har-in-air/ESP8266_MPU9250_MS5611_VARIO/pics/vario_assembly_c.jpg

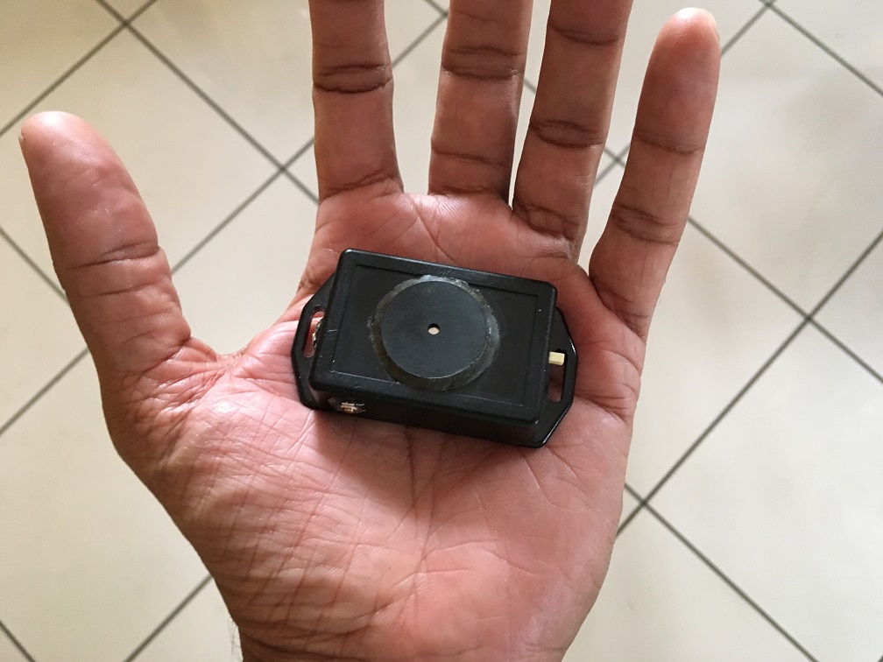
pics/vario_assembly_c.jpg
