har-in-air/ESP8266_MPU9250_MS5611_VARIO/pics/aliexpress_cp2102_usbuart.jpg

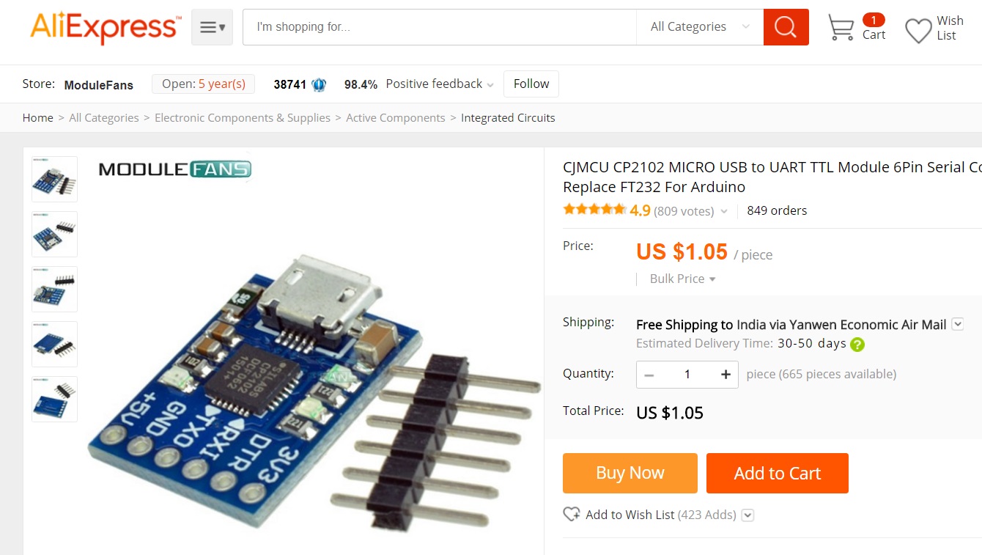
pics/aliexpress_cp2102_usbuart.jpg
