har-in-air/ESP8266_MPU9250_MS5611_VARIO/pics/aliexpress_esp8285_espm2.jpg

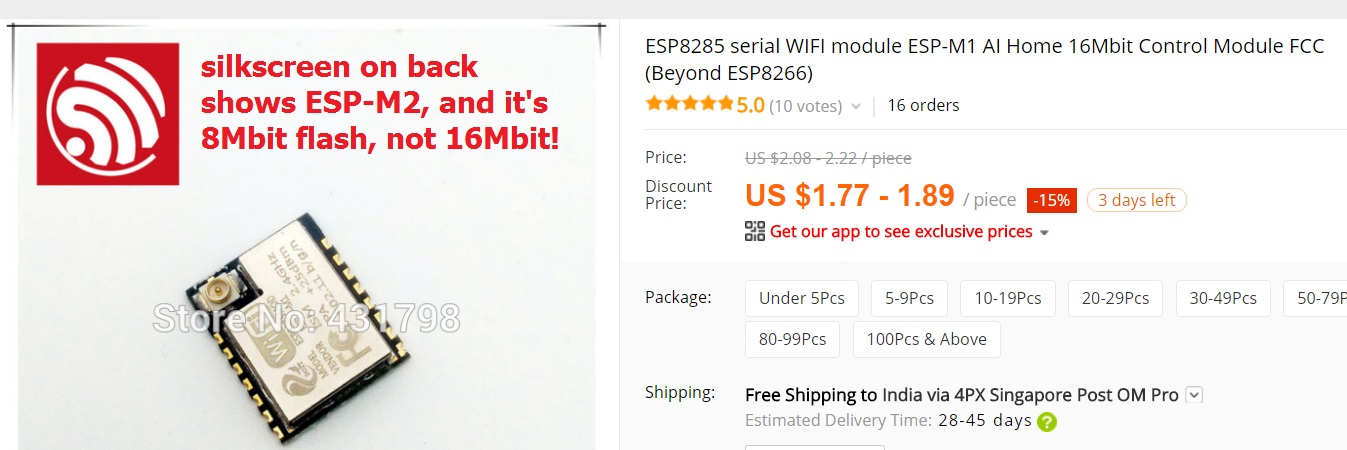
pics/aliexpress_esp8285_espm2.jpg
