har-in-air/ESP8266_MPU9250_MS5611_VARIO/pics/aliexpress_ht7333.jpg

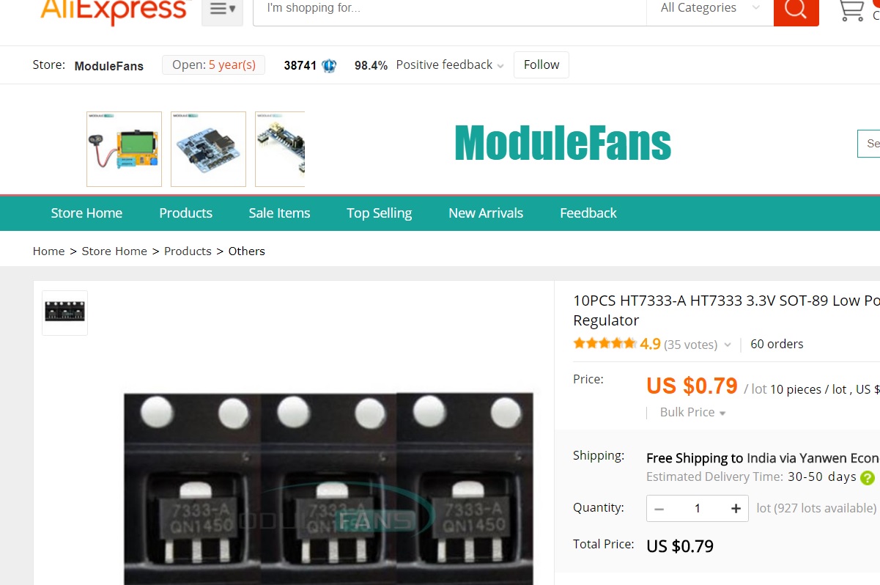
pics/aliexpress_ht7333.jpg
