har-in-air/ESP8266_MPU9250_MS5611_VARIO/pics/aliexpress_loud_piezo.png

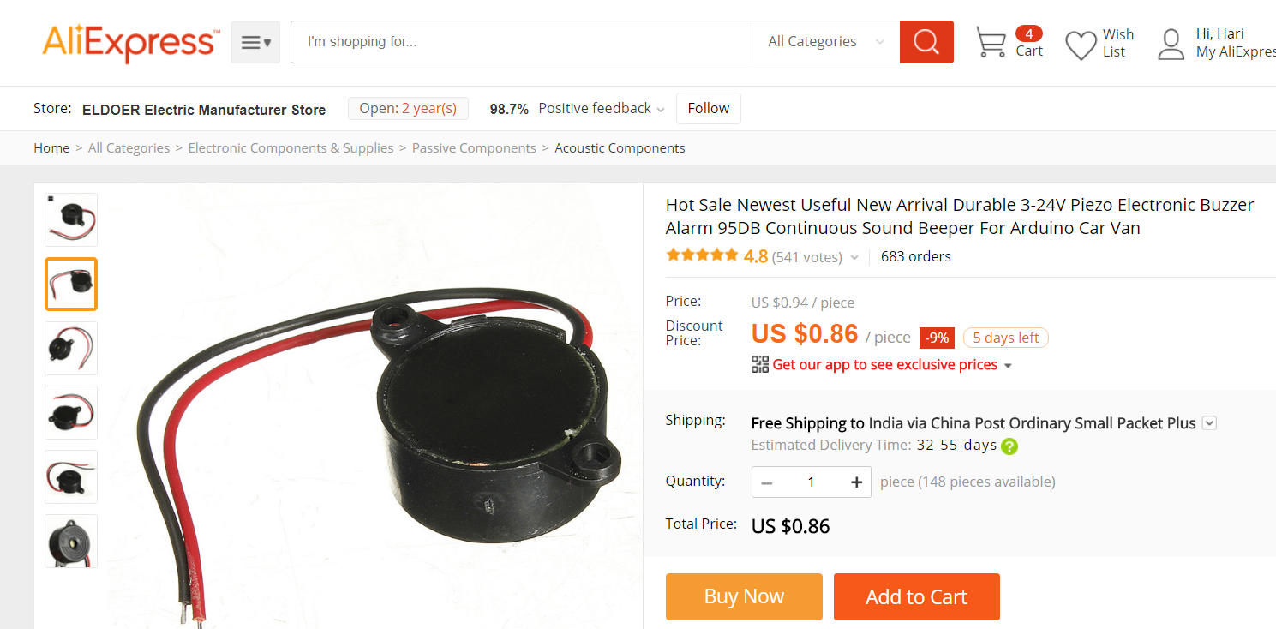
pics/aliexpress_loud_piezo.png
