har-in-air/ESP8266_MPU9250_MS5611_VARIO/pics/antoine_3dprinted_case.png

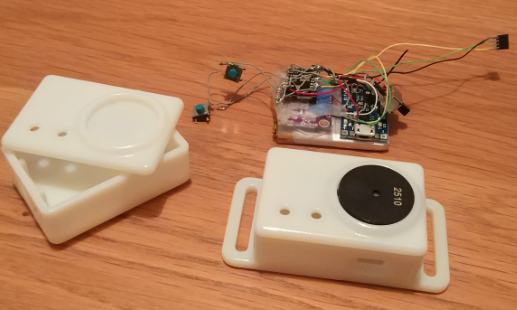
pics/antoine_3dprinted_case.png
