har-in-air/ESP8266_MPU9250_MS5611_VARIO/pics/arduino_board_select.png

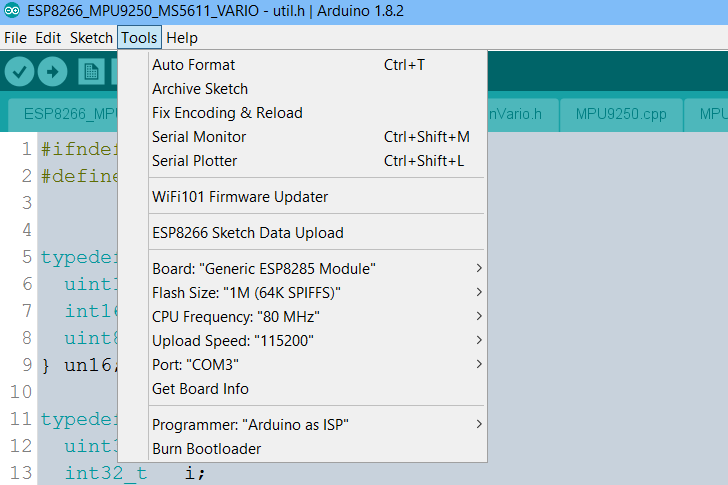
pics/arduino_board_select.png
