har-in-air/ESP8266_MPU9250_MS5611_VARIO/pics/Banggood LiPoly Battery 820mAh.png

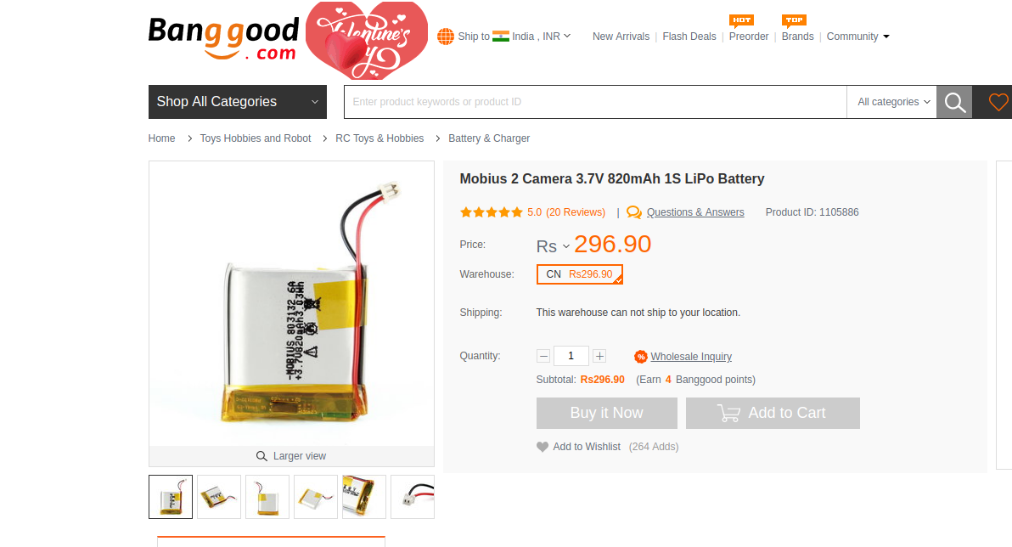
pics/Banggood LiPoly Battery 820mAh.png
