har-in-air/ESP8266_MPU9250_MS5611_VARIO/pics/cjmcu117.jpg

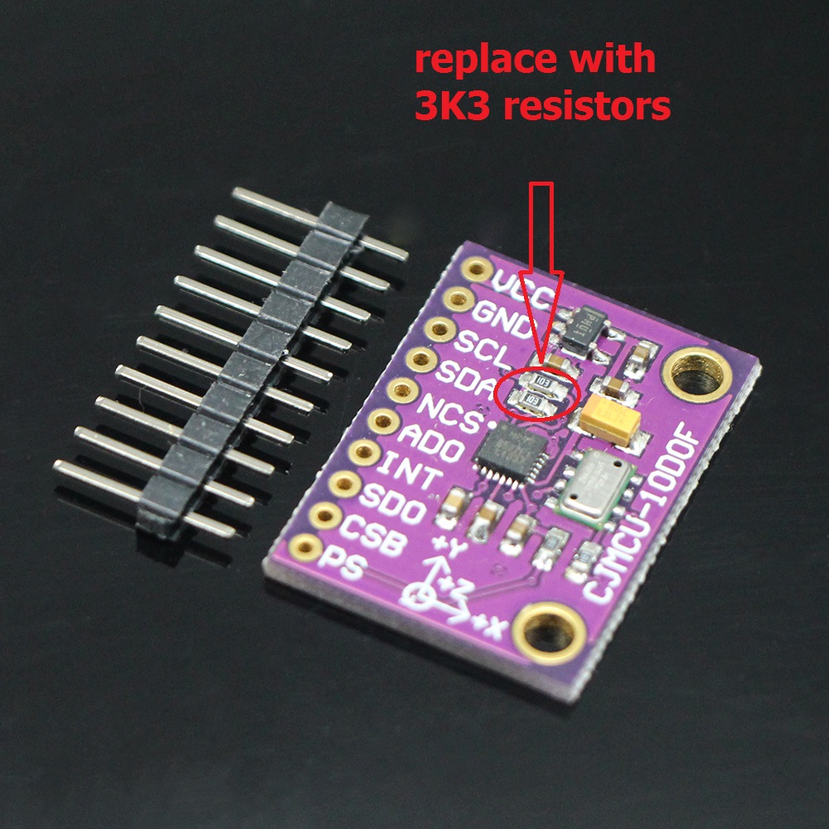
pics/cjmcu117.jpg
