har-in-air/ESP8266_MPU9250_MS5611_VARIO/pics/ebay_cjmcu117.png

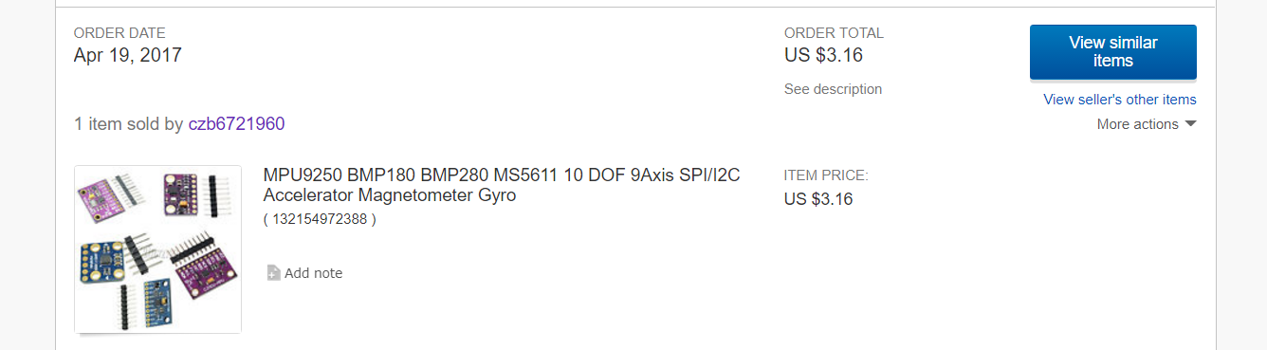
pics/ebay_cjmcu117.png
