har-in-air/ESP8266_MPU9250_MS5611_VARIO/pics/ebay_ht7333.png

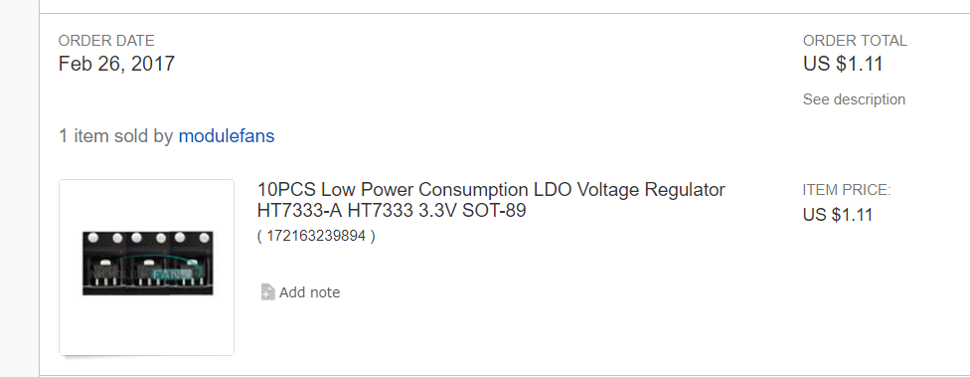
pics/ebay_ht7333.png
