har-in-air/ESP8266_MPU9250_MS5611_VARIO/pics/electrodragon_lipoly_charger.png

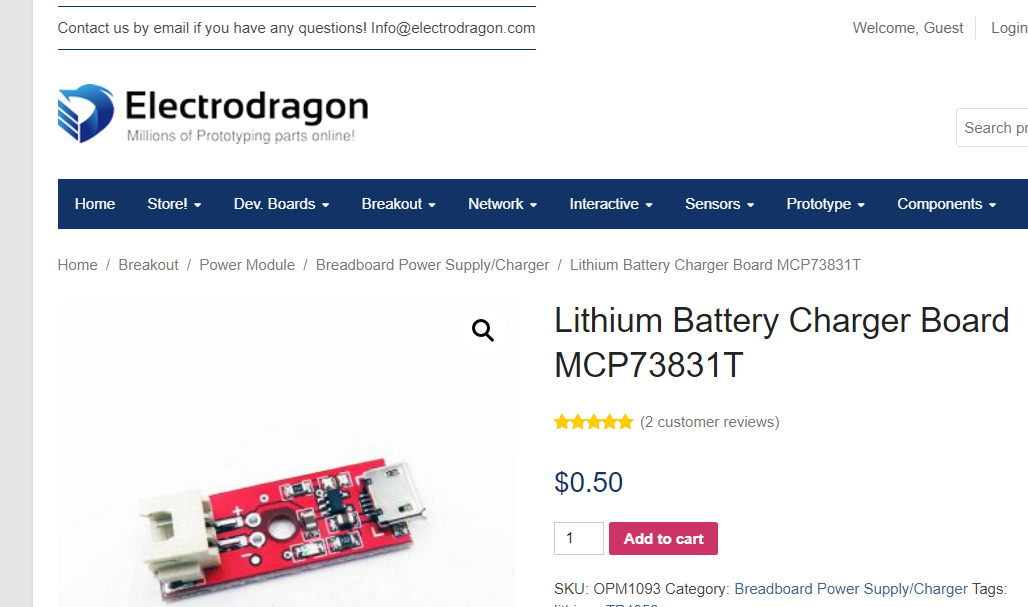
pics/electrodragon_lipoly_charger.png
