har-in-air/ESP8266_MPU9250_MS5611_VARIO/pics/esp8266_vario_memory_used.png

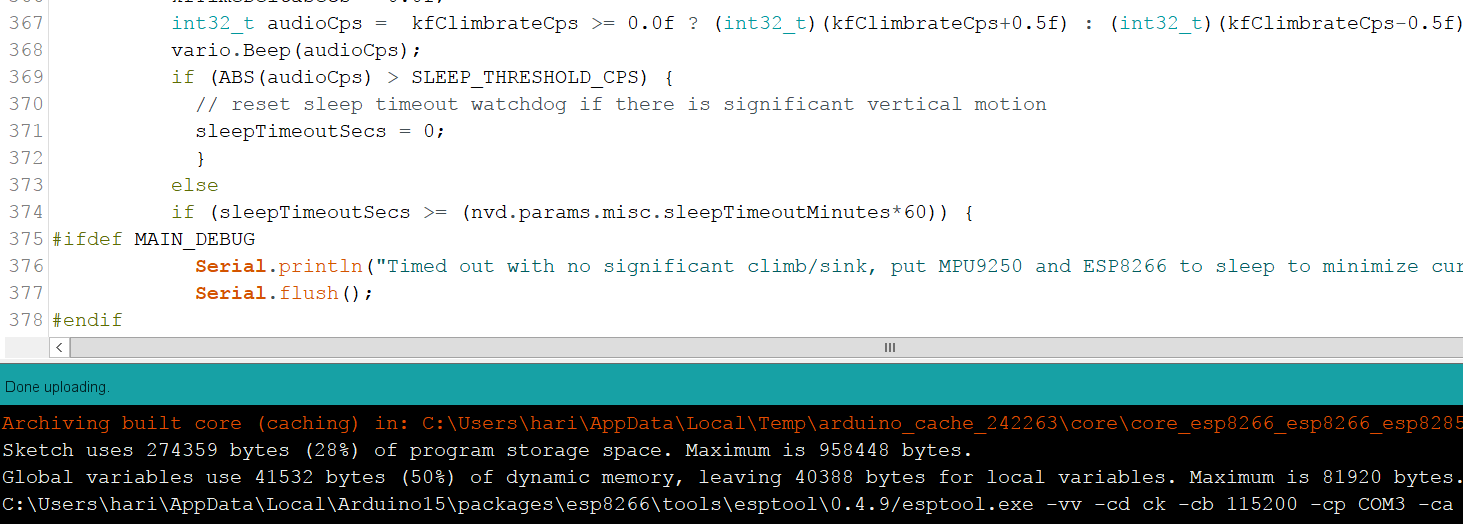
pics/esp8266_vario_memory_used.png
