har-in-air/ESP8266_MPU9250_MS5611_VARIO/pics/esp8285_m2_pinout.png

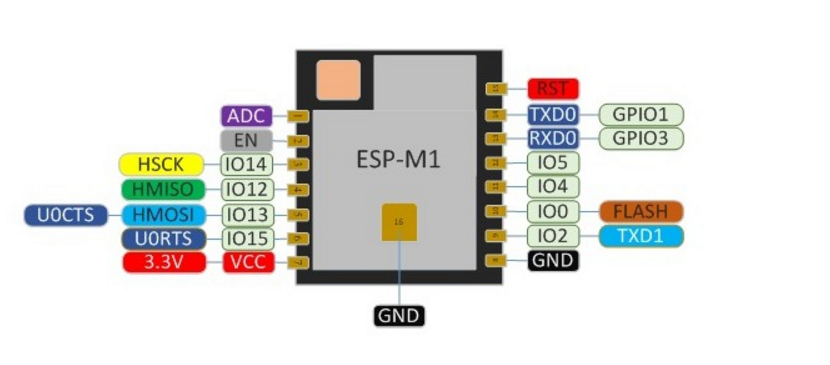
pics/esp8285_m2_pinout.png
