har-in-air/ESP8266_MPU9250_MS5611_VARIO/pics/monitor_normal_flow.png

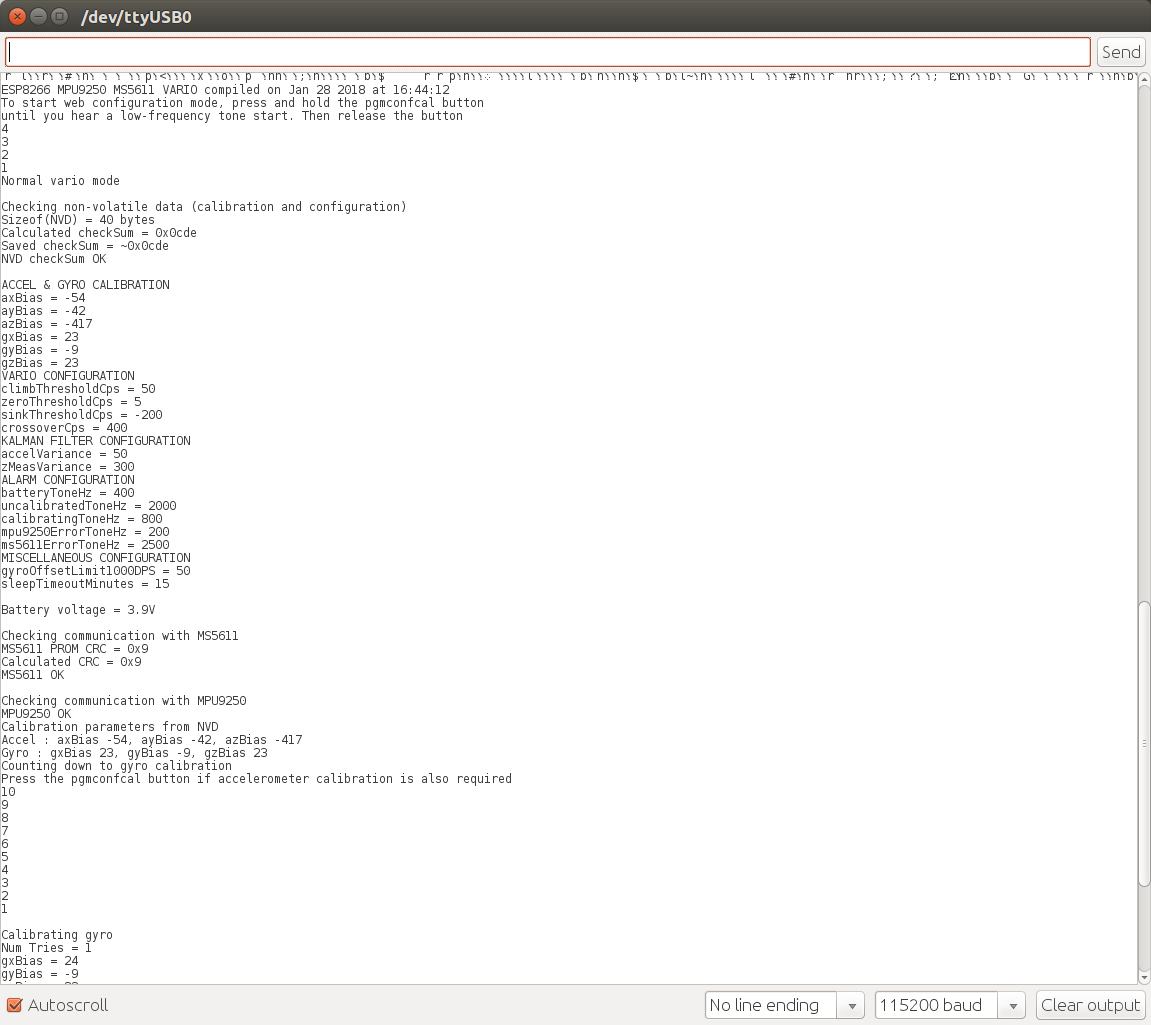
pics/monitor_normal_flow.png
