har-in-air/ESP8266_MPU9250_MS5611_VARIO/pics/vario_schematic.png

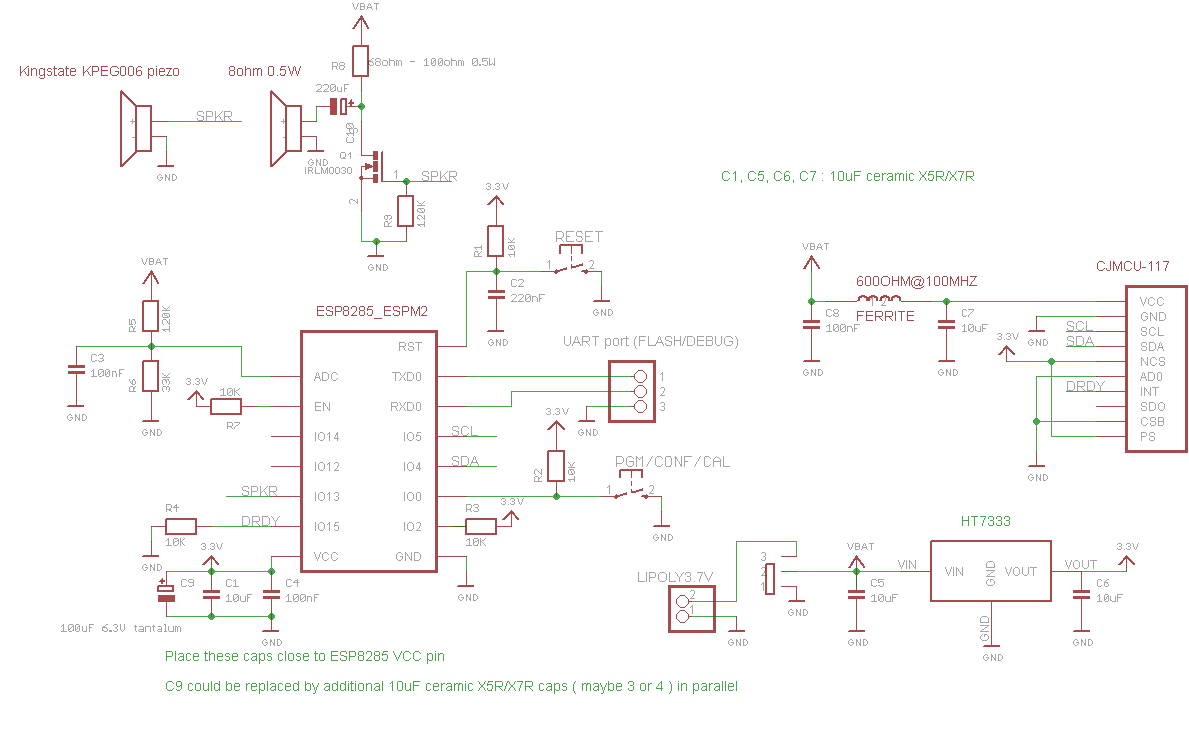
pics/vario_schematic.png
