har-in-air/ESP8266_MPU9250_MS5611_VARIO/pics/vario_assembly_d.jpg

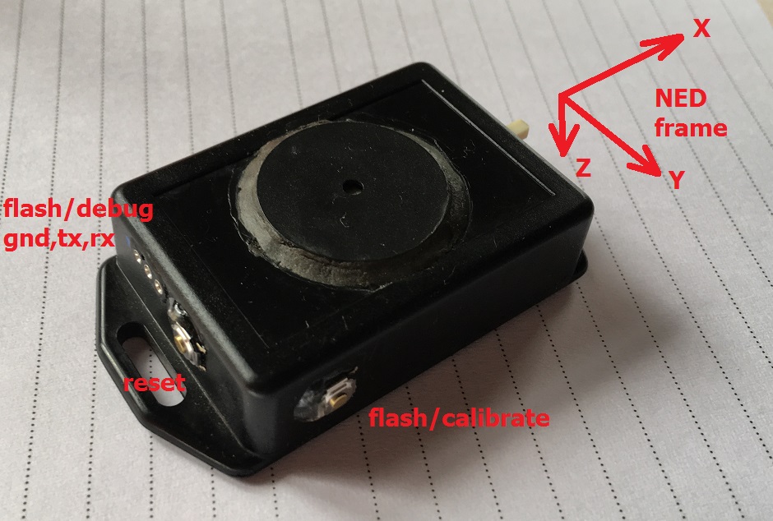
pics/vario_assembly_d.jpg
