har-in-air/ESP8266_MPU9250_MS5611_VARIO/(threads)

Thread 1 (2017-09-16):

high G force compensation during calculation of acceleration z value

ifrew, 2017-09-16:
First off, kudos to you for a great  piece of work! I have this project now working with a mpu6050 gy-86 board too, using the DMP. I wanted to ask where in the code you compensate hi G, low G centripetal forces and whether it really make any difference? I couldn't see it. You made a reference to this in an older project the imu_kalman_altimeter PDF notes. Did you find that it doesn't really matter. Normally when you are thermaling your glider the g forces aren't that high going up.

".....However, the sensor can experience linear acceleration, centripetal forces, etc. in real-world applications.  So I’ve tweaked the AHRS reference code.  I added a flag to allow the AHRS algorithm to use the accelerometer data only when the acceleration vector magnitude is between 0.6g and 1.4g.  In low-g or high-g environments, the code discards the accelerometer data and just integrates the gyroscope rotation-rate data to update the orientation...."

har-in-air, 2017-09-17:
Yes, I decided to use standard Mahony AHRS reference code as an experiment.   I think if you are in sustained acceleration/deceleration for a long time it's  a issue.  Abruptly switching in/out the acceleration input at a hard threshold could also introduce its own issues. So there is definitely a better solution to be found. Someone suggested using gps input as nowadays 5Hz/10Hz units are common.
I have not yet flown with the esp8266 vario (monsoon season here).  I have the feeling it will not be an problem, I am not an acro pilot :). 
Anyway, thanks for the input. Glad to hear it worked for you. The difference between a zero lag vario and a normal pressure based vario is startling at first !
If you put your project on github and give me a link that I could could reference in my readme file, that would be great, I already had someone asking me about using a MPU6050.
regardshari

    On Saturday, 16 September 2017 10:19 AM, ifrew <notifications@github.com> wrote:

 First off, kudos to you for a great piece of work! I have this project now working with a mpu6050 gy-86 board too, using the DMP. I wanted to ask where in the code you compensate hi G, low G centripetal forces and whether it really make any difference? I couldn't see it. You made a reference to this in an older project the imu_kalman_altimeter PDF notes. Did you find that it doesn't really matter. Normally when you are thermaling your glider the g forces aren't that high going up.".....However, the sensor can experience linear acceleration, centripetal forces, etc. in real-world applications. So I’ve tweaked the AHRS reference code. I added a flag to allow the AHRS algorithm to use the accelerometer data only when the acceleration vector magnitude is between 0.6g and 1.4g. In low-g or high-g environments, the code discards the accelerometer data and just integrates the gyroscope rotation-rate data to update the orientation...."—
You are receiving this because you are subscribed to this thread.
Reply to this email directly, view it on GitHub, or mute the thread.

ifrew, 2017-09-17:
Thanks for quick reply! I haven't really used github at all other than to download zip files and use in Visual studio but once I've cleaned up the code I could. Forking, merging, updates, syncing is a bit of a pain! :-) At least to me, a hobbyist coder.

Wrt to the acceleration when turning, I didn't see how you compensated for it in your code, at least not in this project. I was wondering though, why wouldn't just taking the value of the acceleration in the z axis be sufficient rather than the magnitude of the acceleration since we are only interested in then vertical component anyway?

har-in-air, 2017-09-19:
" but why are you just adding up the rotated values to get the acceleration compensated value.? If you wanted the magnitude wouldn't this be the sqrt(axax+ayay+azaz)? "

??? So you've read the pdf file from the kalmanfilter_altimeter_vario project then ?  Just selectively for trolling purposes ?  This isn't a twitter feed, it's a github project issues thread. If you want to contribute to the community, publish your project on github so other people can see and test an alternative implementation approach that uses the Invensense DMP.   That would be a productive use of your time.

ifrew, 2017-09-20:
Not sure why you references trolling in the last comment. I was researching this on the internet trying to find out how to do this and came across your project. In any event, as I said GitHub all new to me, but I've pushed the project I have up now and I downloaded it and it seems to work fine. here is the link. Thanks again for your work on this! https://github.com/ifrew/esp32-vario

romatou18, 2020-03-11:
> Not sure why you references trolling in the last comment. I was researching this on the internet trying to find out how to do this and came across your project. In any event, as I said GitHub all new to me, but I've pushed the project I have up now and I downloaded it and it seems to work fine. here is the link. Thanks again for your work on this! https://github.com/ifrew/esp32-vario

Just getting an interest in altimetre and vario now as a hobbyist. The answer to why not using simply the az component alone and computing the vector norm sqrt(ax*ax+ay*ay+az*az) is certainly because the 3components x,y,z are all impacted by the gravity vector.

This is why when the DMP from the 9250 returns linear acceleration it is on 3components, and when returning the gravity vecor too. This is because if your imu frane is not aligned with the earth / world frame then the gravity vector wont be vertical following the z axis, but a x,y,z vector in the imu frame.

Of course once all vectors you are looking at are translated in the earth/world frame you can co sider that thw gravity vector is exactly vertical and defines the z axis direction.

But until then, when measuring acceleration values from the accelerometer, you cannot assume that the az component represents the vertical acceleration . I.e. if your imu frame's z axis is 45 degrees left or right of the gravity vector, then the value of az will be a function of sin 45.

Or if the imu is aligned differently from the normal orientation i.e. the y axis points down instead of the z axis, then the whole system will have to be rotated in the earth frame.

So the bottom line is the orientation is key, hence AHRS values to compute the gravity vector, the linear acceleration and the acceleration in the world frame.

I'm not.an expert at all but this is what i understood from the papers I've read so far and the remains of my university education ;&)

The imu frame

Closed 2017-09-19.

Thread 2 (2020-04-04):

everything looks okay but doesnt work

gerdal91, 2020-04-04:
Hello , first thank you for sharing your code. I build one for me everything looks okay but doesnt work
it beeps it calibrate  then say start vario but doesnt beep

Battery voltage = 0.1V

Checking communication with MS5611
MS5611 PROM CRC = 0xe
Calculated CRC = 0xe
MS5611 OK

Checking communication with MPU9250
MPU9250 OK
Calibration parameters from NVD
Accel : axBias -703, ayBias 358, azBias -151
Gyro : gxBias -41, gyBias -33, gzBias -25
Counting down to gyro calibration
Press the pgmconfcal button if accelerometer calibration is also required
10
9
8
7
6
5
4
3
2
1

Calibrating gyro
Num Tries = 3
gxBias = -42
gyBias = -31
gzBias = -25
Gyro calibration OK

MS5611 config
MS5611 Calibration Coeffs : 47112 49478 29596 27406 31055 28384
Tavg : 24C
Pavg : 92534Pa
Zavg : 75887cm

KalmanFilter config
zMeasVariance 300
zAccelVariance 50000

Vario beeper config
climbToneCps = 20
zeroesToneCps = 0
sinkToneCps = -200
crossoverCps = 400

Start vario

har-in-air, 2020-04-05:
Try putting some diagnostic code in the loop to toggle an led or print a character to serial port so that you know its not hanging waiting for the DRDY signal from the MPU9250.

gerdal91, 2020-04-05:
Thank you I figured I found I didn't wire the int pin on mpu9250

GÖKHAN ERDAL

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

gerdal91, 2020-04-08:
Hello I have 2 more questions.
1. My vario beeps even with no movement with a period
2. How can I serial print the vario speed  and altitude? I know I need to put in the loop but what I need to put ?

GÖKHAN ERDAL

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

har-in-air, 2020-04-08:
1.  Normal, there is sensor noise.2.  You can't, the code in the loop needs to execute within 2mS because of the sensor sample rate of 500Hz. Print statements take a long time.
    On Wednesday, 8 April, 2020, 11:21:51 am IST, gökhan erdal <notifications@github.com> wrote:

Hello I have 2 more questions.
1. My vario beeps even with no movement with a period
2. How can I serial print the vario speed and altitude? I know I need to put in the loop but what I need to put ?

GÖKHAN ERDAL

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

—
You are receiving this because you modified the open/close state.

Reply to this email directly, view it on GitHub, or unsubscribe.

gerdal91, 2020-04-08:
It doesn’t beeb like in your Video I will record a video tonight

8 Nis 2020 Çar, saat 09:27 tarihinde Hari Nair <notifications@github.com>
şunu yazdı:

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

har-in-air, 2020-04-08:
If you use a beep threshold of 0, it will beep, because 50 percent of the time, the value will be above 0 !

Sent from Yahoo Mail on Android

  On Wed, 8 Apr 2020 at 12:54, gökhan erdal<notifications@github.com> wrote:

It doesn’t beeb like in your Video I will record a video tonight

8 Nis 2020 Çar, saat 09:27 tarihinde Hari Nair <notifications@github.com>
şunu yazdı:

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

—
You are receiving this because you modified the open/close state.

Reply to this email directly, view it on GitHub, or unsubscribe.

gerdal91, 2020-04-08:
I use your default configuration .

8 Nis 2020 Çar, saat 10:27 tarihinde Hari Nair <notifications@github.com>
şunu yazdı:

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

har-in-air, 2020-04-08:
Also, for the demo videos, the audio is programmed to show off the sensitivity of the instrument. Not for paragliding.  You can always change the tonal scale for your application and  liking.

Sent from Yahoo Mail on Android

  On Wed, 8 Apr 2020 at 12:54, gökhan erdal<notifications@github.com> wrote:

It doesn’t beeb like in your Video I will record a video tonight

8 Nis 2020 Çar, saat 09:27 tarihinde Hari Nair <notifications@github.com>
şunu yazdı:

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

—
You are receiving this because you modified the open/close state.

Reply to this email directly, view it on GitHub, or unsubscribe.

har-in-air, 2020-04-08:
For the kalman filter demo video I put this info about the tonal scale in the video description.  

Sent from Yahoo Mail on Android

  On Wed, 8 Apr 2020 at 13:05, gökhan erdal<notifications@github.com> wrote:

I use your default configuration .

8 Nis 2020 Çar, saat 10:27 tarihinde Hari Nair <notifications@github.com>
şunu yazdı:

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

—
You are receiving this because you modified the open/close state.

Reply to this email directly, view it on GitHub, or unsubscribe.

Closed 2020-04-05.
