har-in-air/ESP8266_MPU9250_MS5611_VARIO/ESP8266_MPU9250_MS5611_VARIO.ino

#include <Arduino.h>
#include <Wire.h>
#include "config.h"
#include "util.h"
#include "MahonyAHRS.h"
#include "MPU9250.h"
#include "MS5611.h"
#include "KalmanVario.h"
#include "VarioAudio.h"
#include "cct.h"
#include "nvd.h"
#include "audio.h"
#include "ringbuf.h"
#include "wificonfig.h"

uint32_t 	timePreviousUs;
uint32_t 	timeNowUs;
float 		imuTimeDeltaUSecs; // time between imu samples, in microseconds
float 		kfTimeDeltaUSecs; // time between kalman filter updates, in microseconds

float accel[3]; // in milli-Gs
float gyro[3];  // in degrees/second
float kfAltitudeCm = 0.0f;
float kfClimbrateCps  = 0.0f;

int pinSDA 		  = 4;
int pinSCL 		  = 5;
int pinDRDYInt 	= 15;
int pinAudio 	  = 13;

// pinPgmConfCalBtn (GPIO0) has an external 10K pullup resistor to VCC, pressing the button 
// will ground the pin.
// This button has three different functions : program, configure, and calibrate
// 1. (Pgm)Power on the unit with pgmconfcal button pressed. Or with power on, keep 
//    pgmconfcal pressed and momentarily press the reset button.
//    This will put the ESP8266/ESP8285 into programming mode, and you can flash 
//    the application code from the Arduino IDE.
// 2. (Conf)After normal power on, immediately press pgmconfcal and keep it pressed. After a 
//    few seconds, you will hear a low tone for about 5 seconds.
//    You can release the button as soon as you hear this tone, the unit will now
//    be in web configuration mode. 
// 3. (Cal)After normal power on, wait until you hear the battery voltage feedback beeps and
//    then the countdown to gyroscope calibration. If you press the pgmconfcal button
//    during the gyro calibration countdown, the unit will start accelerometer calibration first. 
//    Accelerometer calibration is only required if the accel calibration values in 
//    flash were never written, or were corrupted.

int pinPgmConfCalBtn = 0;

volatile int drdyCounter;
volatile boolean drdyFlag;

int baroCounter;
int sleepTimeoutSecs;

boolean bWebConfigure;

MPU9250 imu;
MS5611 baro;
KalmanVario kf;
VarioAudio vario;


int battery_SampleVoltage(void) {
	int adcSample = 0;
	for (int inx = 0; inx < 4; inx++) {
		adcSample += analogRead(A0);
		delay(1);
		}
	adcSample /= 4;
	// voltage divider with 120K and 33K to scale 4.2V down to < 1.0V for the ESP8266 ADC
	// actual measurement 0.854V with battery voltage = 4.0V => actual scale up from 
	// resistive divider = 4.0/0.854 = 4.6838
	// adc isn't very accurate either, experimental correction factor ~ 1.04, so effective 
	// scale up is 1.04 * 4.6838
	return (int) ((adcSample*1.04f*4.6838f*10.0f)/1023.0f + 0.5f); //  voltage x 10
	}  

void battery_IndicateVoltage(int bv) {
    int numBeeps;
    if (bv >= 40) numBeeps = 5;
    else
    if (bv >= 39) numBeeps = 4;
    else
    if (bv >= 37) numBeeps = 3;
    else
    if (bv >= 36) numBeeps = 2;
    else  numBeeps = 1;
    while (numBeeps--) {
        audio_GenerateTone(nvd.params.alarm.batteryToneHz, 300);
        delay(300);
        }
    }  

// handles data ready interrupt from MPU9250
void drdy_InterruptHandler() {
  drdyFlag = true;
	drdyCounter++;
	}	

// setup time markers for imu, baro and kalman filter
void time_Init() {
	timeNowUs = timePreviousUs = micros();
	}

inline void time_Update(){
	timeNowUs = micros();
	imuTimeDeltaUSecs = timeNowUs > timePreviousUs ? (float)(timeNowUs - timePreviousUs) : 2000.0f; // if rollover use expected time difference
	timePreviousUs = timeNowUs;
	}
	
// residual current draw in sleep mode is the sum of ESP8266 deep sleep mode current,
// MPU9250 sleep mode current, MS5611 standby current, quiescent current of voltage
// regulators, and miscellaneous current through resistive paths e.g. the
// ADC voltage divider.
void goToSleep() {
	audio_SetFrequency(0); // switch off pwm audio 
	imu.Sleep(); // put MPU9250 in sleep mode
	ESP.deepSleep(0); // ESP8266 in sleep can only recover with a reset/power cycle
	}

	
// if imu calibration data in flash was never initialized or is corrupt, the accel 
// and gyro biases are set to 0, and this uncalibrated state is indicated with a 
// continuous sequence of alternating high and low beeps for 10 seconds.
// !! You must manually calibrate the accelerometer if you hear this alarm, it is
// !! required for normal vario operation.
void indicateUncalibratedAccelerometerGyro() {
	for (int cnt = 0; cnt < 10; cnt++) {
		audio_GenerateTone(nvd.params.alarm.uncalibratedToneHz,500); 
		audio_GenerateTone(nvd.params.alarm.uncalibratedToneHz/2,500);
		}
	}

	
// "no-activity" timeout sleep is indicated with a series of descending
// tones. If you do hear this, switch off the vario as there is still
// residual current draw from the circuit components in sleep mode
void indicateSleep() {
	audio_GenerateTone(2000,1000); 
	audio_GenerateTone(1000,1000);
	audio_GenerateTone(500, 1000);
	audio_GenerateTone(250, 1000);
	}

// problem with MS5611 calibration CRC, assume communication error or bad device. 
void indicateFaultMS5611() {
	for (int cnt = 0; cnt < 10; cnt++) {
		audio_GenerateTone(nvd.params.alarm.ms5611ErrorToneHz,1000); 
		delay(100);
		}
	}

// problem reading MPU9250 ID, assume communication error or bad device. 
void indicateFaultMPU9250() {
	for (int cnt = 0; cnt < 10; cnt++) {
		audio_GenerateTone(nvd.params.alarm.mpu9250ErrorToneHz,1000); 
		delay(100);
		}
	}

void setupVarioMode() {
  wificonfig_wifiOff(); // turn off radio to save power
  Wire.begin(pinSDA, pinSCL);
  Wire.setClock(400000); // set i2c clock frequency AFTER Wire.begin()

  int bv = battery_SampleVoltage();
#ifdef MAIN_DEBUG   
  Serial.printf("\r\nBattery voltage = %d.%dV\r\n", bv/10, bv%10 );
#endif
  battery_IndicateVoltage(bv);
  delay(1000);
  
#ifdef MAIN_DEBUG   
    Serial.println("\r\nChecking communication with MS5611");
#endif
  if (!baro.ReadPROM()) {
#ifdef MAIN_DEBUG   
    Serial.println("Bad CRC read from MS5611 calibration PROM");
    Serial.flush();
#endif
    indicateFaultMS5611(); 
    goToSleep();   // power-cycle to fix this, not reset button
    }
#ifdef MAIN_DEBUG   
    Serial.println("MS5611 OK");
#endif
  
#ifdef MAIN_DEBUG   
    Serial.println("\r\nChecking communication with MPU9250");
#endif
  if (!imu.CheckID()) {
#ifdef MAIN_DEBUG   
    Serial.println("Error reading mpu9250 WHO_AM_I register");
    Serial.flush();
#endif
    indicateFaultMPU9250();
    goToSleep();   // power-cycle to fix this, not reset button
    }
#ifdef MAIN_DEBUG   
    Serial.println("MPU9250 OK");
#endif
  
  if ((nvd.params.calib.axBias == 0) && (nvd.params.calib.ayBias == 0) && (nvd.params.calib.azBias == 0)) {
    indicateUncalibratedAccelerometerGyro(); 
#ifdef MAIN_DEBUG   
    Serial.println("Error : uncalibrated accelerometer, manual calibration is now REQUIRED for vario operation !!");
    Serial.println("When you hear the gyro calibration countdown, press the pgmconfcal button to force");    
    Serial.println("accelerometer calibration as well as gyro calibration");    
#endif    
    }
    
  // load the accel & gyro calibration parameters from the non-volatile data structure
  imu.GetCalibrationParams(&nvd);
  
  drdyCounter = 0;
  drdyFlag = 0;
  // interrupt output of MPU9250 is configured as push-pull, active high pulse. This is connected to
  // pinDRDYInt (GPIO15) which already has an external 10K pull-down resistor (required for normal ESP8266 boot mode)
  pinMode(pinDRDYInt, INPUT); 
  attachInterrupt(digitalPinToInterrupt(pinDRDYInt), drdy_InterruptHandler, RISING);
    
  // configure MPU9250 to start generating gyro and accel data  
  imu.ConfigAccelGyro();
  
  // Vario will attempt to calibrate gyro each time on power up. If the vario is disturbed, it will
  // use the last saved gyro calibration values.
  // The software delays a few seconds so that the unit can be left undisturbed for gyro calibration.
  // This delay is indicated with a series of 10 short beeps. While it is beeping, if you press the
  // pgmconfcal button, the unit will calibrate the accelerometer first and then the gyro.
  // As soon as you hear the long confirmation tone, release the button and
  // put the unit in accelerometer calibration position resting undisturbed on a horizontal surface 
  // with the accelerometer +z axis pointing vertically downwards. You will have some time 
  // to do this, indicated by a series of beeps. After calibration, the unit will generate another 
  // tone, save the calibration parameters to flash, and continue with normal vario operation
  
  boolean bCalibrateAccelerometer = false;
#ifdef MAIN_DEBUG
  Serial.println("Counting down to gyro calibration");
  Serial.println("Press the pgmconfcal button if accelerometer calibration is also required");
#endif  
  for (int inx = 0; inx < 10; inx++) {
    delay(500); 
#ifdef MAIN_DEBUG
  Serial.println(10-inx);
#endif  
    audio_GenerateTone(nvd.params.alarm.calibratingToneHz,50); 
    if (digitalRead(pinPgmConfCalBtn) == 0) {
       bCalibrateAccelerometer = true;
       break;
      }
    }
  if (bCalibrateAccelerometer == true) {  
    // acknowledge calibration button press with long tone
    audio_GenerateTone(nvd.params.alarm.calibratingToneHz, 3000);
#ifdef MAIN_DEBUG   
    Serial.println("Manual accelerometer calibration requested");
    Serial.println("Place vario on a level surface with accelerometer z axis vertical and leave it undisturbed");
    Serial.println("You have 10 seconds, counted down with rapid beeps");
#endif
    for (int inx = 0; inx < 50; inx++) {
      delay(200); 
#ifdef MAIN_DEBUG   
  Serial.println(50-inx);
#endif  
      audio_GenerateTone(nvd.params.alarm.calibratingToneHz,50);
      }
#ifdef MAIN_DEBUG   
    Serial.println("\r\nCalibrating accelerometer");
#endif
    imu.CalibrateAccel();
#ifdef MAIN_DEBUG   
    Serial.println("Accelerometer calibration done");
#endif
    nvd_SaveCalibrationParams(imu.axBias_,imu.ayBias_,imu.azBias_,imu.gxBias_,imu.gyBias_,imu.gzBias_);
    }

#ifdef MAIN_DEBUG   
    Serial.println("\r\nCalibrating gyro");
#endif
  // normal power-on operation flow, always attempt to calibrate gyro. If calibration isn't possible because 
  // the unit is continuously disturbed (e.g. you turned on the unit while already flying), indicate this and
  // use the last saved gyro biases. Otherwise, save the new gyro biases to flash memory
  if (imu.CalibrateGyro()) {
#ifdef MAIN_DEBUG   
    Serial.println("Gyro calibration OK");
#endif
    audio_GenerateTone(nvd.params.alarm.calibratingToneHz, 1000);
    nvd_SaveCalibrationParams(imu.axBias_,imu.ayBias_,imu.azBias_,imu.gxBias_,imu.gyBias_,imu.gzBias_);
    }
  else { 
#ifdef MAIN_DEBUG   
    Serial.println("Gyro calibration failed");
#endif
    audio_GenerateTone(nvd.params.alarm.calibratingToneHz, 1000);
    delay(500);
    audio_GenerateTone(nvd.params.alarm.calibratingToneHz/2, 1000);
    }
    
  delay(1000);  
      
#ifdef MAIN_DEBUG   
    Serial.println("\r\nMS5611 config");
#endif
  baro.Reset();
  baro.GetCalibrationCoefficients(); // load MS5611 factory programmed calibration data
  baro.AveragedSample(4); // get an estimate of starting altitude
  baro.InitializeSampleStateMachine(); // start the pressure & temperature sampling cycle

#ifdef MAIN_DEBUG   
  Serial.println("\r\nKalmanFilter config");
#endif  
  // initialize kalman filter with barometer estimated altitude, and climbrate = 0.0
  kf.Config((float)nvd.params.kf.zMeasVariance, 1000.0f*(float)nvd.params.kf.accelVariance, KF_ACCELBIAS_VARIANCE, baro.zCmAvg_, 0.0f, 0.0f);

#ifdef MAIN_DEBUG   
  Serial.println("\r\nVario beeper config");
#endif
  vario.Config();

  
  time_Init();
  kfTimeDeltaUSecs = 0.0f;
  baroCounter = 0;
  sleepTimeoutSecs = 0;
  // circular buffer of latest z-earth acceleration samples, needed to ensure we use the acceleration samples that are
  // in sync with the pressure-derived altitude samples
  ringbuf_Init(); 
#ifdef MAIN_DEBUG   
  Serial.println("\r\nStart vario");
#endif
  }

  
void setup() {
  delay(100);
#ifdef MAIN_DEBUG    
  Serial.begin(115200);
  Serial.printf("\r\nESP8266 MPU9250 MS5611 VARIO compiled on %s at %s\r\n", __DATE__, __TIME__);
#endif
  bWebConfigure = false;
  pinMode(pinPgmConfCalBtn, INPUT);
  audio_Config(pinAudio); 
#ifdef MAIN_DEBUG    
  Serial.println("To start web configuration mode, press and hold the pgmconfcal button");
  Serial.println("until you hear a low-frequency tone start. Then release the button");
#endif
  for (int cnt = 0; cnt < 4; cnt++) {
#ifdef MAIN_DEBUG    
    Serial.println(4-cnt);
#endif
    delay(1000);
    }
  if (digitalRead(pinPgmConfCalBtn) == 0) {
    bWebConfigure = true;
#ifdef MAIN_DEBUG    
  Serial.println("Web configuration mode selected");
#endif
    // 5 second long tone with low frequency to indicate unit is now in web server configuration mode.
    // You can release the button as soon as the tone starts.
    // After you are done with web configuration, switch off the vario as the wifi radio
    // consumes a lot of power.
    audio_GenerateTone(200, 5000);
    }
   else {
#ifdef MAIN_DEBUG    
  Serial.println("Normal vario mode");
#endif        
    }
   
#ifdef MAIN_DEBUG    
  Serial.println("\r\nChecking non-volatile data (calibration and configuration)");  
#endif
  nvd_Init();

  if (bWebConfigure == true) { 
    wificonfig_SetupAPWebServer(); 
    }
  else {
    setupVarioMode();
    }
  }
	

void loop(){
  if (bWebConfigure == true) {
    // web configuration loop
    wificonfig_HandleClient();
    }
  else { 
    // normal vario loop
	  if ( drdyFlag == true ) { // 500Hz ODR => 2mS sample interval
		  drdyFlag = false;
		  time_Update();
#ifdef CCT_DEBUG		
		  cct_SetMarker(); // set marker for estimating the time taken to read and process the data
#endif		
		  // accelerometer samples (ax,ay,az) in milli-Gs, gyroscope samples (gx,gy,gz) in degrees/second
		  imu.GetAccelGyroData(accel, gyro); 
		
      // CJMCU-117 board is placed upside down in the case (when speaker is pointing up). We arbitrarily decide that 
		  // the CJMCU-117 board silkscreen +X points "forward" or "north"  (in our case, the side with the power switch), 
		  // silkscreen +Y points "right" or "east", and silkscreen +Z points down. This is the North-East-Down (NED) 
		  // right-handed coordinate frame used in our AHRS algorithm implementation.
		  // The required mapping from sensor samples to NED frame for our specific board orientation is : 
		  // gxned = gx, gyned = gy, gzned = gz (clockwise rotations about the axis must result in +ve readings on the axis)
		  // axned = -ax, ayned = -ay, azned = -az (when the axis points down, axis reading must be +ve)
		  // The AHRS algorithm expects rotation rates in radians/second
      // Acceleration data is only used for orientation correction when the acceleration magnitude is between 0.75G and 1.25G
      float accelMagnitudeSquared = accel[0]*accel[0] + accel[1]*accel[1] + accel[2]*accel[2];
      int bUseAccel = ((accelMagnitudeSquared > 562500.0f) && (accelMagnitudeSquared < 1562500.0f)) ? 1 : 0;
		  imu_MahonyAHRSupdate6DOF(bUseAccel,imuTimeDeltaUSecs/1000000.0f, DEG_TO_RAD(gyro[0]), DEG_TO_RAD(gyro[1]), DEG_TO_RAD(gyro[2]), -accel[0], -accel[1], -accel[2]);
		
		  float gravityCompensatedAccel = imu_GravityCompensatedAccel(-accel[0], -accel[1], -accel[2], q0, q1, q2, q3);
      ringbuf_AddSample(gravityCompensatedAccel);  

		  baroCounter++;
		  kfTimeDeltaUSecs += imuTimeDeltaUSecs;
		  if (baroCounter >= 5) { // 5*2mS = 10mS elapsed, this is the sampling period for MS5611, 
			  baroCounter = 0;    // alternating between pressure and temperature samples
        // one altitude sample is calculated for every new pair of pressure & temperature samples
			  int zMeasurementAvailable = baro.SampleStateMachine(); 
			  if ( zMeasurementAvailable ) { 
          // average earth-z acceleration over the 20mS interval between z samples
          // z sample is from when pressure conversion was triggered, not read (i.e. 10mS ago). So we need to average
          // the acceleration samples from the 20mS interval before that
				  float zAccelAverage = ringbuf_AverageOldestSamples(10); 
				  kf.Update(baro.zCmSample_, zAccelAverage, kfTimeDeltaUSecs/1000000.0f, &kfAltitudeCm, &kfClimbrateCps);
          // reset time elapsed between kalman filter algorithm updates
				  kfTimeDeltaUSecs = 0.0f;
				  int32_t audioCps =  kfClimbrateCps >= 0.0f ? (int32_t)(kfClimbrateCps+0.5f) : (int32_t)(kfClimbrateCps-0.5f);
          vario.Beep(audioCps);                
          if (ABS(audioCps) > SLEEP_THRESHOLD_CPS) { 
            // reset sleep timeout watchdog if there is significant vertical motion
            sleepTimeoutSecs = 0;
            }
          else
				  if (sleepTimeoutSecs >= (nvd.params.misc.sleepTimeoutMinutes*60)) {
#ifdef MAIN_DEBUG				
					  Serial.println("Timed out with no significant climb/sink, put MPU9250 and ESP8266 to sleep to minimize current draw");
					  Serial.flush();
#endif					
					  indicateSleep(); 
					  goToSleep();
					  }  	
				  }
			  }
#ifdef CCT_DEBUG			
		  uint32_t elapsedUs =  cct_ElapsedTimeUs(); // calculate time  taken to read and process the data, must be less than 2mS
#endif
		  if (drdyCounter >= 500) {
			  drdyCounter = 0;
			  sleepTimeoutSecs++; // 500 * 2mS = 1 second
#ifdef IMU_DEBUG
			  float yaw, pitch, roll;
			  imu_Quaternion2YawPitchRoll(q0,q1,q2,q3, &yaw, &pitch, &roll);
			  // Pitch is positive for clockwise rotation about the +Y axis
			  // Roll is positive for clockwise rotation about the +X axis
			  // Yaw is positive for clockwise rotation about the +Z axis
			  // Magnetometer isn't used, so yaw is initialized to 0 for the "forward" direction of the case on power up.
			  Serial.printf("\r\nY = %d P = %d R = %d\r\n", (int)yaw, (int)pitch, (int)roll);
			  Serial.printf("ba = %d ka = %d kv = %d\r\n",(int)baro.zCmSample_, (int)kfAltitudeCm, (int)kfClimbrateCps);
#endif			
#ifdef CCT_DEBUG			
			  Serial.printf("Elapsed %dus\r\n", (int)elapsedUs); // ~ 700 uS, so plenty of headroom
#endif
			  }
	    }
		} 
	}
