har-in-air/ESP8266_MPU9250_MS5611_VARIO/(commit log)

2017-08-04 initial commit
    Tested software build environment is Arduino 1.8.2 on Windows 10 x64.
    Most ESP8266 or ESP8285 modules will work as long as they bring out the GPIO pins that are used in this project. I used an ESP8285 ESP-M2 module because it's literally thumbnail sized and I wanted everything to fit in a small case. If using an ESP8266 module, select "Generic ESP8266 module" in Arduino. If you use a development board such as the Wemos D1 or Nodemcu, bear in mind that the onboard USB-UART chip will draw power even when the ESP8266 and MPU9250 are in sleep mode, so the extra current drain will be a problem for the auto power off feature, as well as for normal active mode.
    The circuit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
    [ESP8266_MPU9250_MS5611_VARIO.ino]
2017-09-17 update config.h
    climb, lifty-air, sink thresholds fixed for normal use
    [config.h]
2017-09-27 recommend HT7833 over HT7333 LDO regulator
2018-01-10 Add files via upload
    user configurable parameters now configurable via wifi webpage with the vario acting as a wifi access point.
    vario audio generation reworked
    imu algorithm modified to use acceleration feedback only if acceleration magnitude is within bounds
    code cleanup
    [ESP8266_MPU9250_MS5611_VARIO.ino]
2018-01-10 Add files via upload
    corrected limits for some fields
    [wificonfig.cpp]
2018-01-10 Add files via upload
    minor typo correction
    [nvd.cpp]
2018-01-10 Add files via upload
    Add 100uF tantalum cap close to ESP8285 VCC pin to ensure wifi current spikes do not result in supply brownout
2018-01-11 Add files via upload
    fixed uncalibrated alarm two tone generation, clean up comments in config.h
    [ESP8266_MPU9250_MS5611_VARIO.ino, config.h]
2018-01-11 Add files via upload
    fix setfrequency for negative frequencies
    [audio.cpp]
2018-01-11 Add files via upload
    Reduce delay on startup before battery voltage indication from 5s to 4s
2018-01-12 Add files via upload
    fix for use with milliGs instead of Gs
2018-01-12 Add files via upload
    accumulate kalman filter update time in microseconds
2018-01-12 Add files via upload
    fix time update to handle rollover
    [ESP8266_MPU9250_MS5611_VARIO.ino]
2018-01-13 Add files via upload
    Add 8ohm speaker option
2018-01-13 Add files via upload
    modify current limiting resistor for 8ohm speaker
2018-01-13 Add files via upload
    modified 8ohm speaker drive circuit
2018-01-29 Add files via upload
    modify window for use of acceleration data to correct orientation in mahony filter.
    average acceleration samples over window synced with the pressure sensor derived altitude samples for fusion in kalman filter, this requires a circular buffer of latest acceleration samples
    [ESP8266_MPU9250_MS5611_VARIO.ino]
2018-02-02 Update README.md
    add link to antoine lomberty's 3d printer files for a case
2018-02-02 Update README.md
    added link to the esp32 imu baro gps data logger /docs directory for demo of kalman sensor fusion algorithm
